Orange-Duster/Plastic-Fantastic/3MF/Plastic Fantastic - Nosecone Tip.3mf

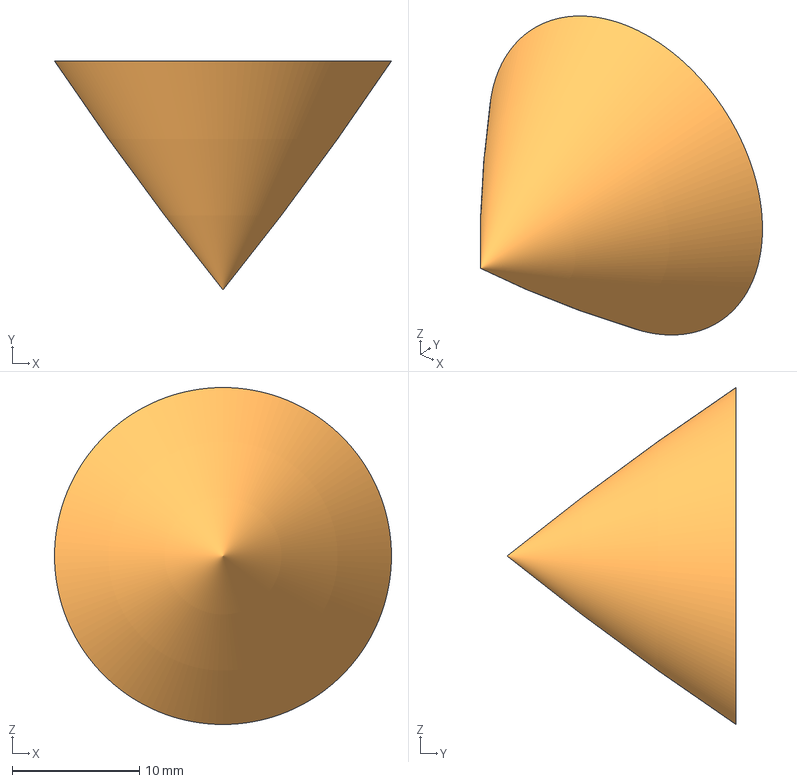
[picture p1: CAD file, 2023-05-13]
3MF/Plastic Fantastic - Nosecone Tip.3mf
26.5 x 18.0 x 26.5 mm
