Orange-Duster/Plastic-Fantastic/3MF/Plastic Fantastic - Nosecone Body Jolly Logic.3mf

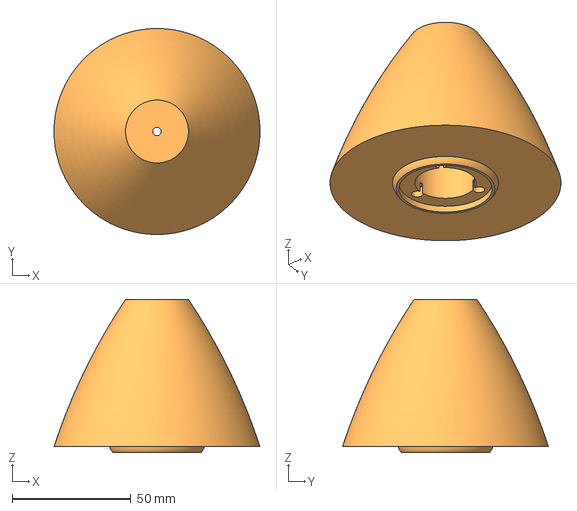
[picture p2: CAD file, 2023-05-13]
3MF/Plastic Fantastic - Nosecone Body Jolly Logic.3mf
86.7 x 86.7 x 64.5 mm
