Orange-Duster/Plastic-Fantastic/3MF/Plastic Fantastic 4 Fin - Aligner.3mf

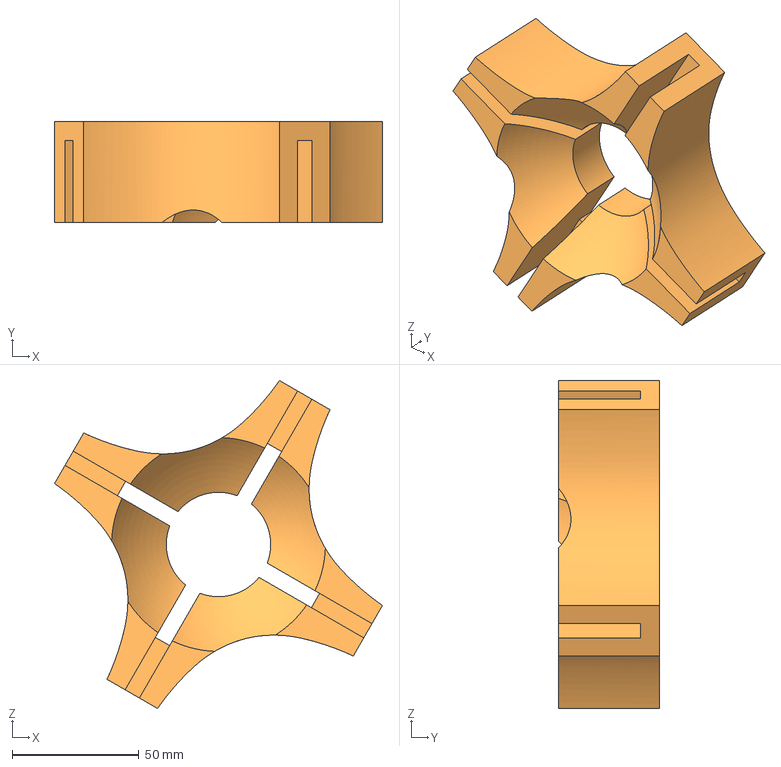
[picture p3: CAD file, 2023-05-13]
3MF/Plastic Fantastic 4 Fin - Aligner.3mf
129.3 x 40.0 x 129.3 mm
