Orange-Duster/Plastic-Fantastic/3MF/Plastic Fantastic - Parachute Holder.3mf

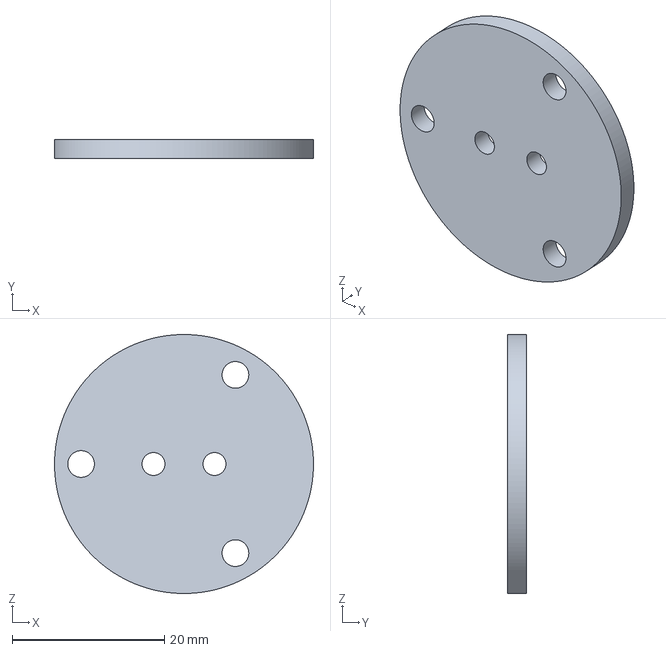
[picture p4: CAD file, 2023-05-13]
3MF/Plastic Fantastic - Parachute Holder.3mf
34.0 x 2.50 x 34.0 mm
