Orange-Duster/Plastic-Fantastic/3MF/Plastic Fantastic - Fin2.3mf

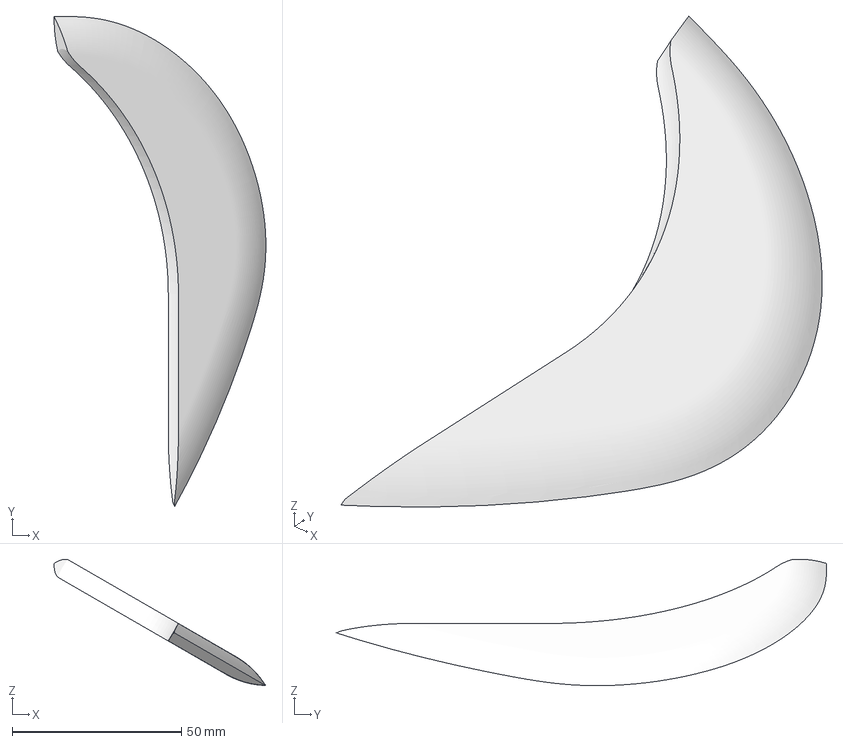
[picture p5: CAD file, 2023-05-13]
3MF/Plastic Fantastic - Fin2.3mf
62.6 x 144.9 x 37.4 mm
