Orange-Duster/Plastic-Fantastic/3MF/Plastic Fantastic - Aligner.3mf

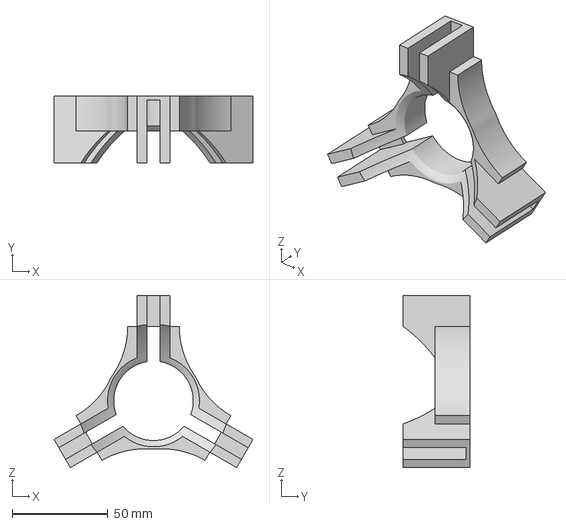
[picture p6: CAD file, 2023-05-13]
3MF/Plastic Fantastic - Aligner.3mf
103.8 x 35.0 x 89.9 mm
