Orange-Duster/Plastic-Fantastic/3MF/Plastic Fantastic - Nosecone Base.3mf

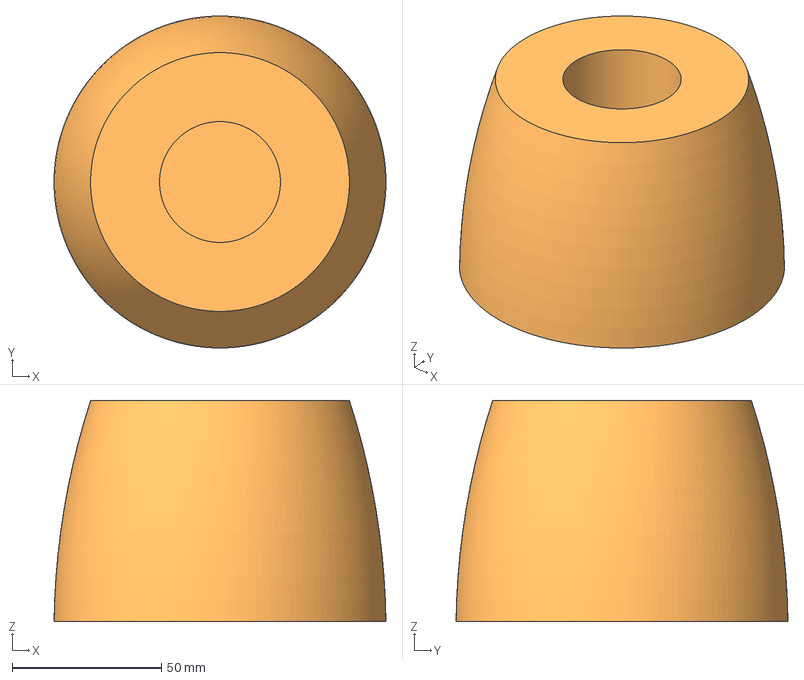
[picture p7: CAD file, 2023-05-13]
3MF/Plastic Fantastic - Nosecone Base.3mf
111.3 x 111.3 x 74.1 mm
