Orange-Duster/Plastic-Fantastic/(list of files, cad)

Other CAD files:
3MF/Plastic Fantastic - Nosecone Body Estes.3mf
